Voor-Monky/SteRoP/3a.jpg

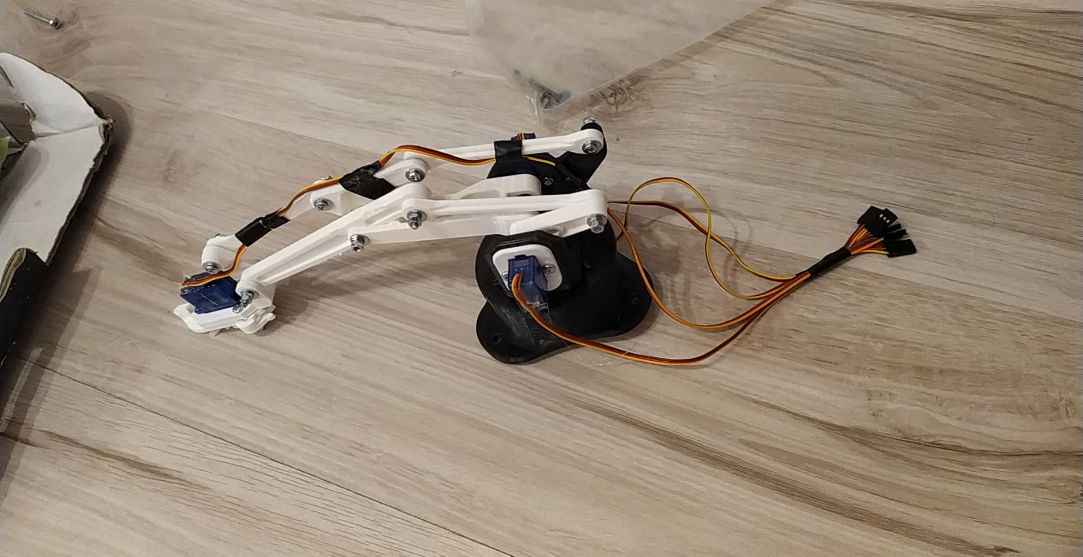
3a.jpg
