Voor-Monky/SteRoP/1a.jpg

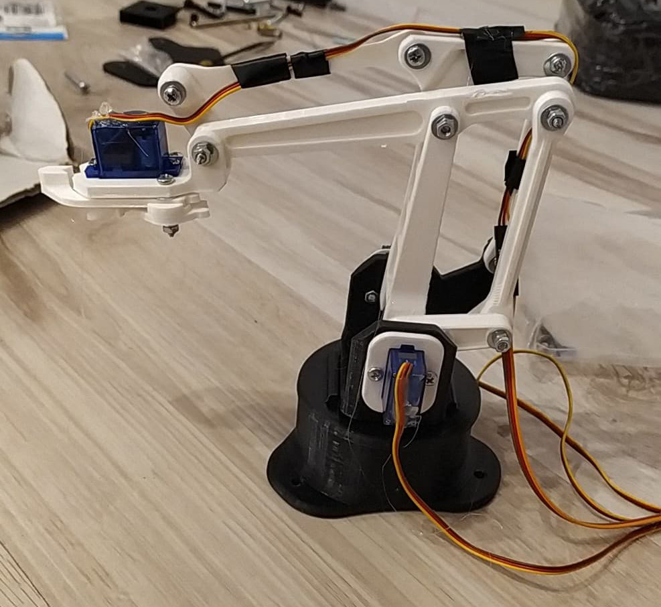
1a.jpg
