Voor-Monky/SteRoP/README.md

# SteRoP
Repozytorium do projektu Sterowniki Robotów na Politechnice Wrocławskiej
