Voor-Monky/SteRoP/vlcsnap-error157.png

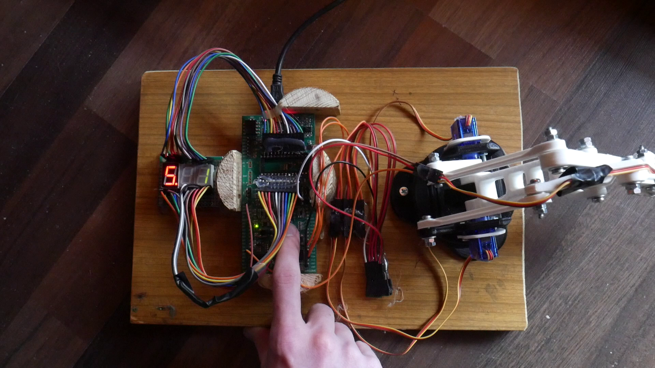
vlcsnap-error157.png
