Voor-Monky/SteRoP/wyswietlacz.png

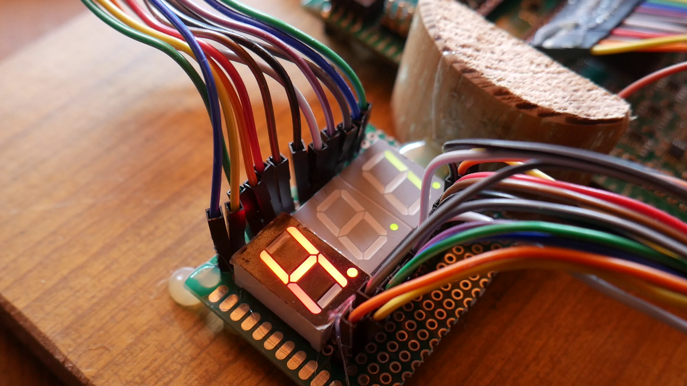
wyswietlacz.png
