Voor-Monky/SteRoP/Zegary.PNG

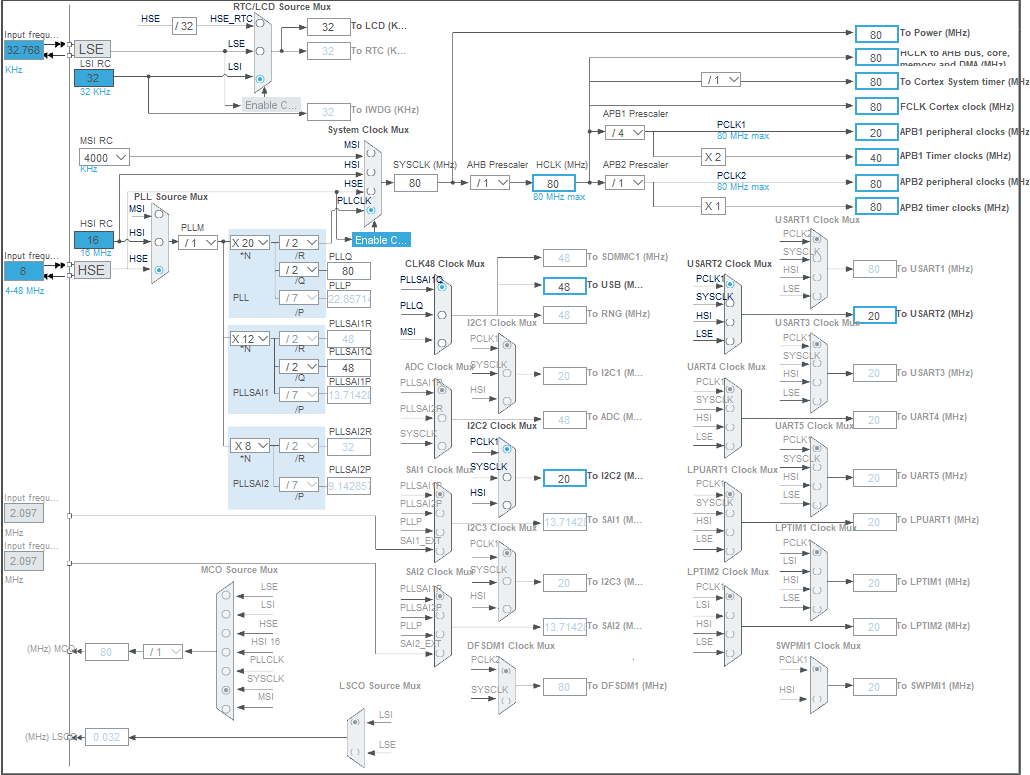
Zegary.PNG
