Voor-Monky/SteRoP/(commit log)

2020-04-26 Działający PWM dla serwomechanizmów
2020-05-06 Kod z obsługą LCD przycisków i poczatek kinematyk
    Wersja Kodu zawierająca obsługę wyświetlacza LCD we wszystkich wariantach - skonfigurowane sterowanie przycisków, przyjmowanie i wyświetlanie wartości przy kinematyce odwrotnej
2020-06-10 Funkcja obsługująca wyświetlacz
    Case obsługujący wyświetlacz urządzenia
